lhr-solar/KiCAD-Sharepoint/README.md

# KiCAD-Bild
Common KiCAD library for Longhorn Racing Solar
