lhr-solar/KiCAD-Sharepoint/docs/Ordering.md

To start a PCB prototype order, go to [JLCPCB](https://jlcpcb.com/) and sign in to the LHR Solar account. Ask a lead if you need login info. Then upload your gerber zip file as shown below.

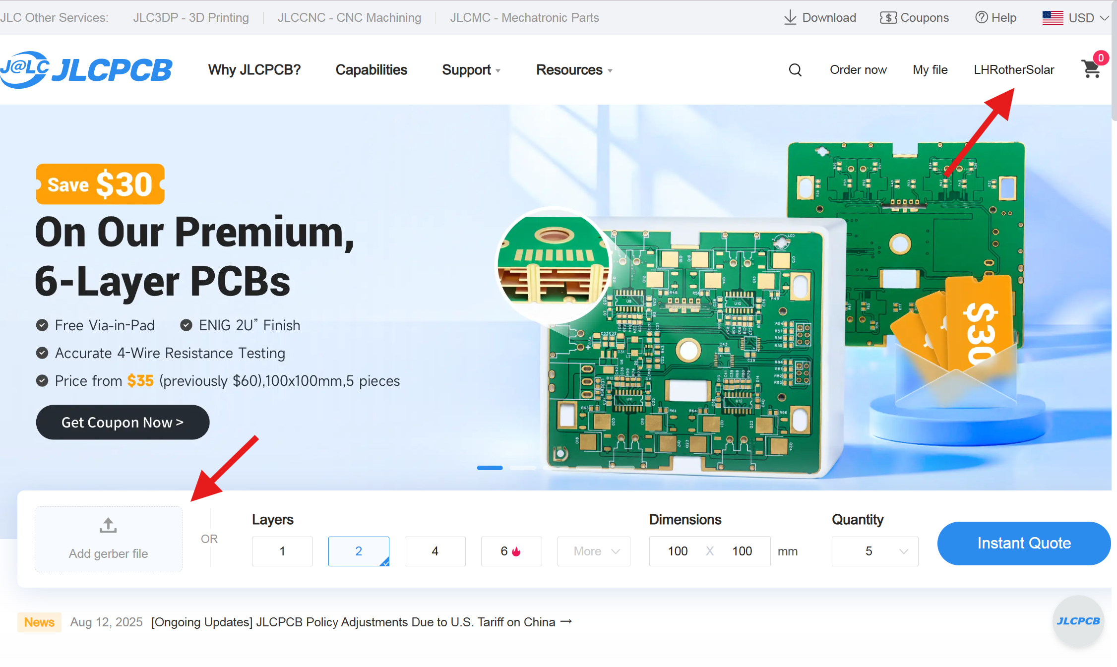
[picture p13: docs/img/JLC-Home.png]
JLCPCB Upload


You should see an order page like this. Check that the base material is FR-4 for rigid boards and that the layer count and dimensions match your design in KiCad.

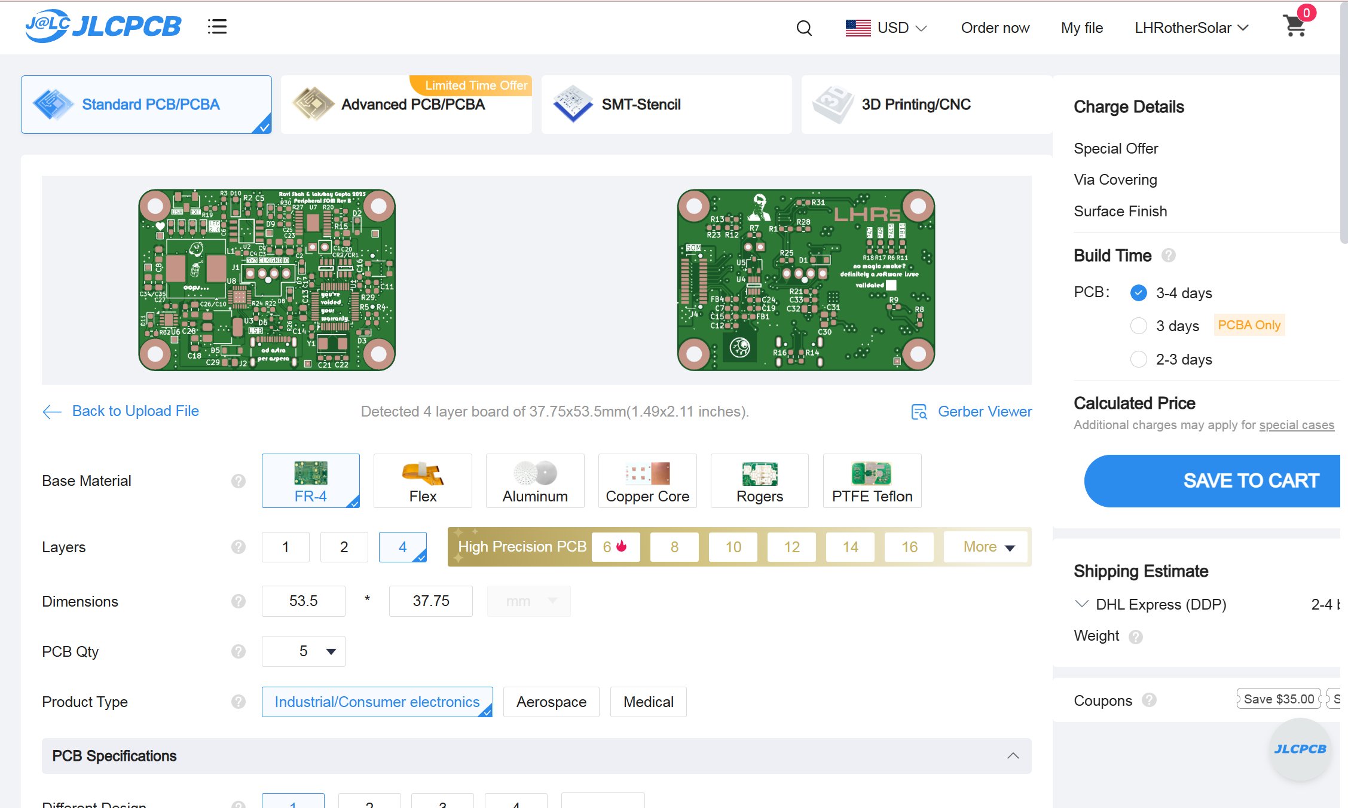
[picture p14: docs/img/JLC-Order.png]
JLCPCB Order


For PCB Specifications, keep the default values for everything unless you need to change a certain option.

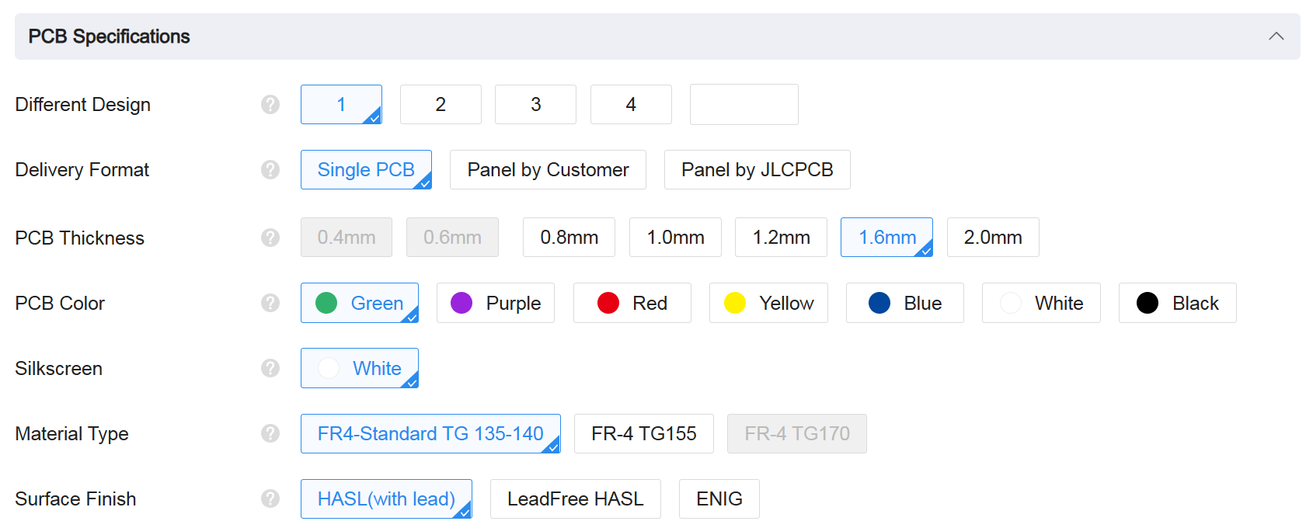
[picture p15: docs/img/JLC-Specs.png]
JLCPCB Specs


After modifying relevant specifications, click "Save To Cart" and proceed to checkout.
