lhr-solar/KiCAD-Sharepoint/docs/Assembly.md

## How to Design for Assembly
TODO
DFM type shi
## JLC Assembly Tutorial
TODO
take through website. clarify ambiguous stuff
## Common PCBA Pitfalls
TODO
things i ran into that could fuck up assembly
## Cost Reduction
TODO
how to bs ur way to low-cost assembly
