lhr-solar/KiCAD-Sharepoint/(threads)

Thread 12 (2025-08-23):

Add KiCAD constraints

Lakshay983, 2025-08-23:
Put JLCPCB constraints in readme:

https://github.com/lhr-solar/UTSVT-KiCadLibraries?tab=readme-ov-file#standard-constraints-for-laying-out-board
^ Ignore the text ones, those are fake

Lakshay983, 2025-10-06:
Addressed in #11

Closed 2025-10-06.
