lhr-solar/KiCAD-Sharepoint/(commit log)

2025-03-17 add connectors.pretty
2025-04-14 add standard connectors
2025-08-12 Added BPS thermistor
2025-08-13 Stuff that was added from VCU: 3d models, LSOM, logic analyzer, RPP IC and nmos (#2)
    * VCU components: logic analyzer connector, LSOM, USBC, TVS diode, LDO, ESP, etc
    * added some stuff, fixed footprints to have 3d models
    * made logic analyzer symbol to be more aesthetic to satiate lakshay's needs
    * embed 3d models
2025-08-13 Update Shared Symbols (#3)
    * change 12V -> 24V
    * add 1x7 connector
    * updated shared symbols
    * forgot to change peripheral connector to nanofit
2025-08-14 Add PP design block for 24v (#4)
    [PowerProtection.kicad_sch]
2025-08-20 add el3h7 symbol and footprint (#8)
2025-08-20 remove some default footprints for symbols and fix datasheets (#9)
2025-08-23 add PSOM symbol (#5)
    * add PSOM symbol
    * meanie lakshay
    * add footprint/models
    * appease lakshay
    * add holes + outline + usb
    * rename to PeripheralSOM
    * oopsie woopsie
    * mh pin
    * fixed?
    * distinct MH pins
    * add p/n field to symbol
    ---------
2025-09-06 Small changes from the latest version of VCU (#13)
    * i fucked up the git history again
    * small zener diode change
    * small tweaks to prevent solder paste errors
    * fixed logic analyzer connector
2025-09-27 Add XT-30 vertical footprint (#16)
2025-09-28 Lsom (#15)
    * created LSOM symbol
    * review council lsom connector
    * Revert "review council lsom connector"
    This reverts commit 76b69428bf252613a815704e40b01c805e9b134f.
    * lsom symbol
    * Fixed LSOM Symbol
    * attempting to get footprints to work
    * lsom symbol
    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
2025-10-06 Add mkdocs (#11)
    * add mkdocs shell
    * test
    * why is windows stupid
    * blah blah
    * remove unused
    * ??
    * hello from orbastro
    * placeholder files
    * organize better
    * fix
    * basic desc
    * add some setup
    * ibom
    * finish kicad setup
    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
2025-10-09 Mx150 connectors (#19)
    * initial connector schematic
    * MX150 footprints w/ 3d models (no guards)
    * pin numbers on silkscreen
    * added p/n to symbols
    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
2025-10-11 LSOM symbol and 3d model (#22)
    * fixes
    * lsom symbol fixes
    * LSOM symbol revisions
    * gamer leds
    * led 3d models
    * renamed uarts
    * LSOM 3d model
    * fixing merge conflicts
    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
2025-10-11 Changing the footprint and symbol of the NMOS (#21)
    * nmos symbol bs
    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
2025-10-11 LSOM SPI pins (#23)
2025-10-11 Lsom symbol (#24)
    * LSOM SPI pins
    * asldqpoigweoqfqwf
2025-10-11 Lsom symbol (#25)
    * LSOM model
    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
2025-10-13 53307 connector (#26)
2025-10-14 LSOM footprint change to user drawings (#27)
    * Precharge resistor symbol added to Special
    * LSOM footprint changed to user drawings
2025-10-29 fix psom mounting hole on symbol (#30)
2025-11-08 added new mx150 headers, fixed pinouts, renamed footprint files (#31)
2025-12-28 Add Fuse symbol+footprint and modify Logic Analyzer Symbol (#34)
    * add fuse symbol and modify logic analzyer symbol
    * move fuse to utsvt_power
2026-01-02 horizontal nanofit footprints
2026-01-09 Vcu rev b (#36)
    * new power nmos (removed cuz same as main)
    * fixed lsom and usbc
    * 1x3 and 2x6 nanofits
2026-03-15 HV fuse
2026-05-10 usb_pd_boost block (#41)
    * usb_pd_boost initial design
    * addressed comments, pls review
    * for review again
    * addressedyurp
    * embedded datasheets
    * reviewed and ready
    [usb_pd_boost.kicad_sch]
2026-05-11 USB PD Design Block (#42)
    * added design block
    * added USB port, temporary PD controller and boost converter
    * added CYPD3177
    * power paths
    * picked FETs, added TVS diodes for power path, USB, D+ D-
    * changed D+ D- diode bc the old one was highk microscopic
    * smth
    * flipped fets
    * symbol library yea
    * lowk forgot to push the right thing
    * lcsc
    * footprints
    * better naming so labels don't conflict
    [USB_PD.kicad_sch]
2026-05-11 usb_pd_boost symbols+footprints (#50)
2026-05-12 100 PIN MCU (#40)
    * maid
    * dog food
    * lakshay comments addressed
    * post 319 brain fried stuff
    * work
    * updated boot sw
    * embedded sheets working
    * symbols
    * symbol library
    * please approve
2026-05-12 Pwr mux block (#43)
    * prelim power mux design block is finished. need to make nice description still though
    * updated description for pwr mux
    * I forgor to have the same ground label everywhere :^)
    * Datasheet for pwrmux added to symbol
    * changed ST to MuxOut pullup, adjusted load cap, fixed PN, removed default res values
    * added info about input range. changed to have power symbols & one heirarchical label. mentioned automatic mode config. muxout is now an output
    * lowered max thresholds for switching, embedded datasheet into symbol
    * i forgor to edit the .json with new resistor values
    * only uses hierarchical labels now, seperate symbol library
    ---------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
    [Power_Mux.kicad_sch]
2026-05-12 5V -> 3.3V LDO (#47)
    * added LDO symbol
    * 5v to 3.3v LDO
    * added reverse current diode and some datasheet values for designers
    * assigned designators
    * replaced symbol with default, replaced footprint with one that matches datasheet exactly
    * removed unnessecary LDO symbol library
    * there was a whitespace after P/N
    [LDO.kicad_sch]
2026-05-12 24v to 12v, 5v, 3v3 buck blocks (#45)
    * 3.3 buck block
    * bucksssS
    * buck
    * made changes
    * review addressed
    * fixed designators
    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
    [12VBuck.kicad_sch, 3V3Buck.kicad_sch, 5VBuck.kicad_sch]
2026-05-13 ESP32 Design Block (#44)
    * cleaned up, added P/N and Datasheets
    * switched to SathSwitch
    * embedded datasheets, switched to normal diode (not in stock rn, but for general design is better)
    * changed resistor symbol & to LCSC P/N label
    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
2026-05-13 CAN Transceiver (#52)
    * pls review :O
    * switched to split termination + hopefully fixed symbols
    * fixed issues
    * hopefully fixed footprints + parts
    [CAN_Transceiver.kicad_sch]
2026-05-14 100PinMCU Design Block symbols and footprints (#53)
    * sym and mod
    * change to special
2026-05-14 Merge USB PD symbols (#51)
    * merged USB PD symbols into utsvt_ics symbol lib
    * added all symbols
    * updated SI799 symbol, PD design block should now reference correct symbols
    * added testpoints and LED to design block
    * updates
    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
    [USB_PD.kicad_sch]
2026-05-14 added test points to 5V buck to merge (#54)
    [5VBuck.kicad_sch]
2026-05-14 48 pin mcu done
    * init - STM32G431CBT6
    * review lil shah
    * imma sleep now
    * reviews addressed
    * lakers in 7 plssssss
    * boooooooooahhhhhhhhhh
    * dun dun dun
    * boom
2026-05-15 updated footprints, embedded datasheets/3D (#55)
2026-05-17 updated resistor footprint from 0201 to 0603 (#56)
    * updated resistor footprint from 0201 to 0603
    * updated wrong resistor value
    [5VBuck.kicad_sch]
2026-05-17 updated 12V/3V buck resistor footprint + added test points (#57)
    [12VBuck.kicad_sch, 3V3Buck.kicad_sch]
2026-05-18 updated 5V/12V buck capacitor footprint (#58)
    * updated 5V buck capacitor footprint
    * 12V Buck update for capacitor footprint to 0603
    [12VBuck.kicad_sch, 5VBuck.kicad_sch]
2026-05-20 PD Block Update (#63)
    - deleted usb protection
    - testpoints are now external
    - labels
    [USB_PD.kicad_sch]
2026-05-23 48 pin MCU swd swapped, fixed now
    [48PinMCU.kicad_sch]
2026-05-28 100PinMCU_NoBreakoutPC13-15 (#65)
    [100PinMCU.kicad_sch]
2026-05-29 added 3557-2 fuseholder (#66)
2026-05-29 3557-2 Fuseholder Fixes (#67)
    * added courtyard, changed to 2 pins
    * deleted 3568 fuse
2026-06-01 Add TPS2117 Footprint to UTSVT_Power (#68)
2026-07-14 Contactor Design Block (#69)
    * knicks spurs
    * replace good resistors with communist ones
    * fixed footprints + 3d models
    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
    [Contactor.kicad_sch]
2026-07-15 Rev x power protection (#61)
    * importing new VCU
    * deleted VCU with complete PP schem
    * unvlo made, updates changed on review file system still bad
    * added first round TVS, fixed file system, added MOSFET fork, and updated caps
    * added TVS, new file system
    * updated LCSC P/N
    * embedded datasheets and added hierarchical ground
    * removed project folder
    * added missed emebedded datasheet
    * removed project folder
    * removed project folder
    * fixed unvlo and made source and gate hieracrhical labels
    * removed project folder
    * fixed unvlo and made source and gate hieracrhical labels
    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
    [PowerProtection.kicad_sch]
2026-08-06 Design block fixes (#70)
    * fixed 3d models for 100 pin, esp, can, pwr mux
    * symbol + footprint fixes
    * jk real 48 pin fixes
    * jk I'm still a chud
    * more fixes... imma sleep tho
    * whitelist production files in gitignore
    * added all footprints + 3d models to design blocks
    * fixed all nanofits + can conn symbols
    * fixed lv pwr conn
    * oops I forgot a couple things
    * deleted lib tables
    * added dtms
    * UTSVT to LHRS
    * more nanofit pinout fixes
    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
    [100PinMCU.kicad_sch, 12VBuck.kicad_sch, 3V3Buck.kicad_sch, 48PinMCU.kicad_sch, 5VBuck.kicad_sch, CAN_Transceiver.kicad_sch, Contactor.kicad_sch, ESP32.kicad_sch]
2026-08-25 New G4 MCUs (#71)
    * did 48 halfway thru 100
    * added embedded mcu datasheets
    * fix boot sw
    * looks g
    * added rgb led
    * added embedded datasheets
    * fixed leds + datasheets
    * swd header, rgb led again, other shit
    * pin header 2.54
    * datasheet embedded :/
    * usb hierarchical
    * fix footprint
    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
    [100PinMCU.kicad_sch, 48PinMCU.kicad_sch]
2026-08-26 MCU Block Fix (+3V3, P/N, RGB)
    [100PinMCU.kicad_sch, 48PinMCU.kicad_sch]
2026-09-05 12vbuck (#73)
    * 12vbuck
    * adress reviews
    * new passives
    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
    [12VBuck.kicad_sch, 3V3Buck.kicad_sch, 5VBuck.kicad_sch, usb_pd_boost.kicad_sch]
2026-09-05 USB CONN design block (#77)
    * USB CONN design block
    * bidirectional, updated comments
    [USB-C Connector.kicad_sch]
2026-09-06 Rev x power protection (#74)
    * made schem prettier updated cap value
    * added cap to OV
    * python script made
    * updated library parts + new 15V TVS diode
    * updated libraries + changed resistor orientaiton
    * added new data sheets and fixed linking
    * changed linbrary linking
    * updated power diodes for VCAP libary link
    * updated library link to SMA diode + made sheet look cleaner
    [PowerProtection.kicad_sch]
2026-09-06 12V can symbols (#79)
2026-09-09 Buck converter Updates (#81)
    * updated footprints, p/n, and checked for stocks for every passive
    * updated caps, added new pn
    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
    [12VBuck.kicad_sch]
2026-09-10 Rev x power protection (#80)
    * updated reistor P/N for new resistor divider + 33 ohm resistor
    * updated to match standard parts list
    * finalize P/N selection
    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
    [PowerProtection.kicad_sch]
2026-09-19 Usb conn design block (#82)
    * added PN for USB C
    * bing bing bong resoved conflict
    * bing bong
    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
    [USB-C Connector.kicad_sch]
2026-09-26 Contactor economizer (#75)
    All design blocks should be good. P/N, symbols, datasheets, etc. should be good.
    * fixed merge conflicts from local files not updating for some reason
    * gitignore stuff
    * fixed merge conflicts and added 12V power mux
    * added power mux design block
    * added bq chip symbol
    * fixed merge of lhrs_power symbols
    * added footprints for economizer, mux, and bms transceiver
    * fixed some erc issues
    * First draft of 12V Buck-boost design block has been created
    * removed temp folder
    * added transformer footprint
    * added 3d model for transformer, changed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
    [12VBuck.kicad_sch, 12VBuckBoost.kicad_sch, Contactor.kicad_sch, Power_Mux_12V.kicad_sch]
2026-10-10 Rev a fixes (#84)
    * updated buck block
    * tp symbol + usb fixes
    * updated .gitignore
    * updated conns
    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
    [100PinMCU.kicad_sch, 12VBuck.kicad_sch, 12VBuckBoost.kicad_sch, 48PinMCU.kicad_sch, CAN_Transceiver.kicad_sch, Contactor.kicad_sch, ESP32.kicad_sch, LDO.kicad_sch]
2026-10-26 IMU Design Block (#85)
    * IMU Design Block
    * IMU Details
    * IMU Design Block Final
    * cleaning up for merge
    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
2026-11-13 Ldo diode (#86)
    * replaced old diode with standardized part
    * pp resistors standardized
    * pp calcs corrected
